Mimosa-oceanis/Mimosa-Power-Board-Hat/Images/Mimosa-Power-Hat.jpg

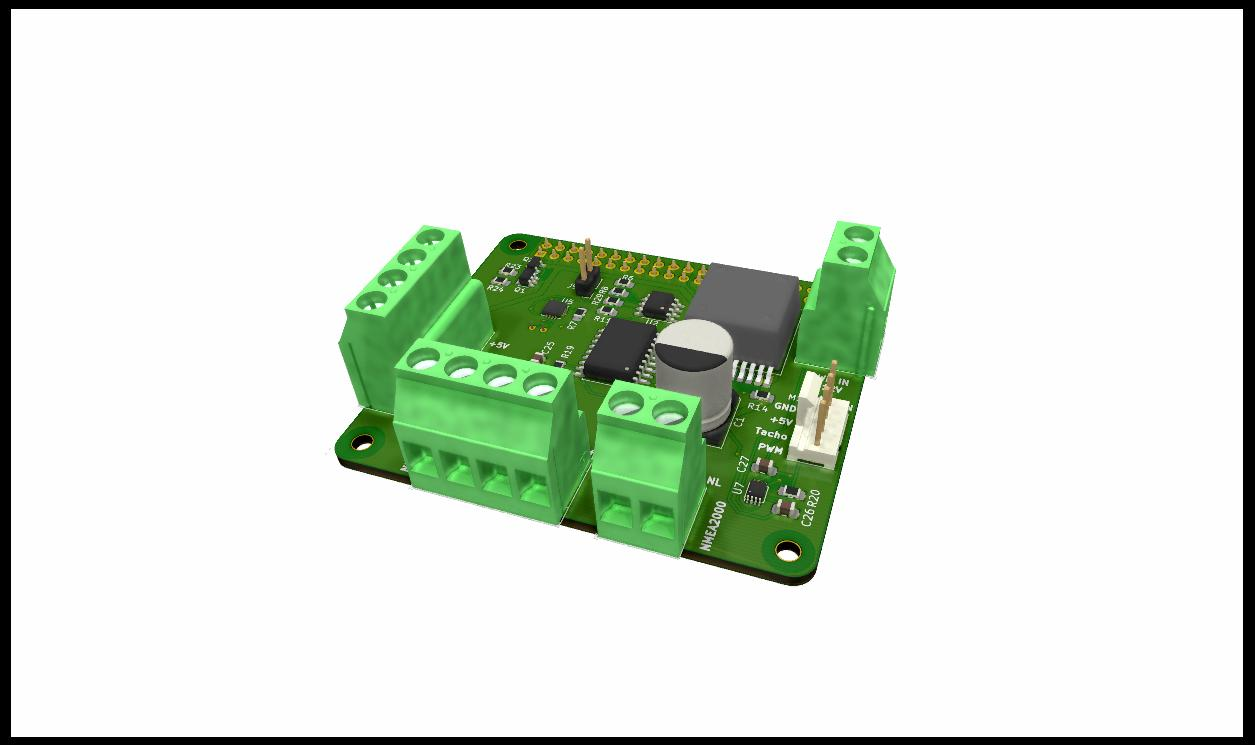
Images/Mimosa-Power-Hat.jpg
