Mimosa-oceanis/Mimosa-Power-Board-Hat/3D/Mimosa-Hat.FCStd

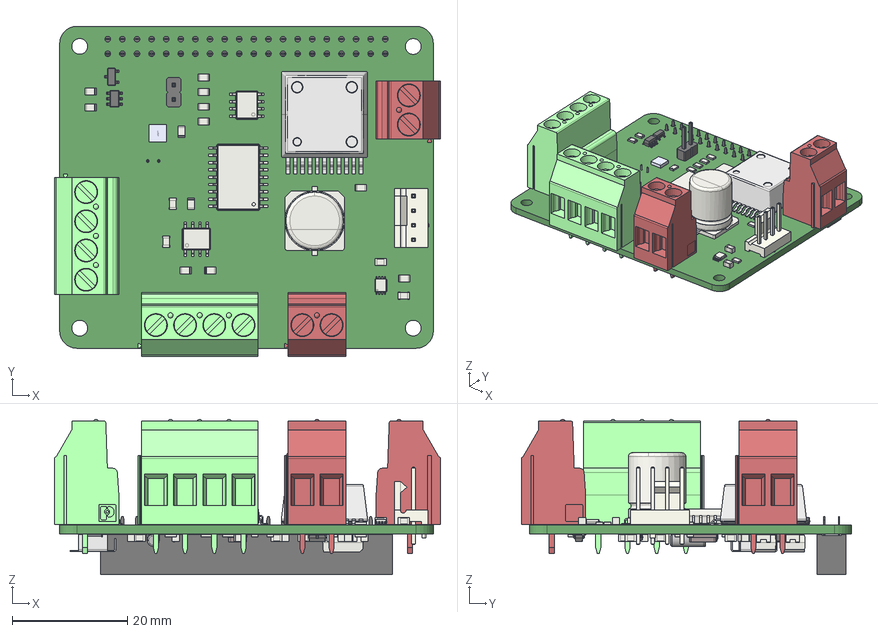
[picture p3: CAD file, 2020-08-15]
3D/Mimosa-Hat.FCStd
67.1 x 57.5 x 27.0 mm
