Mimosa-oceanis/Mimosa-Power-Board-Hat/(threads)

Thread 4 (2021-01-30):

Mixed handsolder and fine pitch components

llessa, 2021-01-30:
Replace fine pith components for ones that can be handsoldering handled.
p.ex: AB0805-T3
