Mimosa-oceanis/Mimosa-Power-Board-Hat/prod/PDF/Mimosa-Power-Hat-B_SilkS.pdf

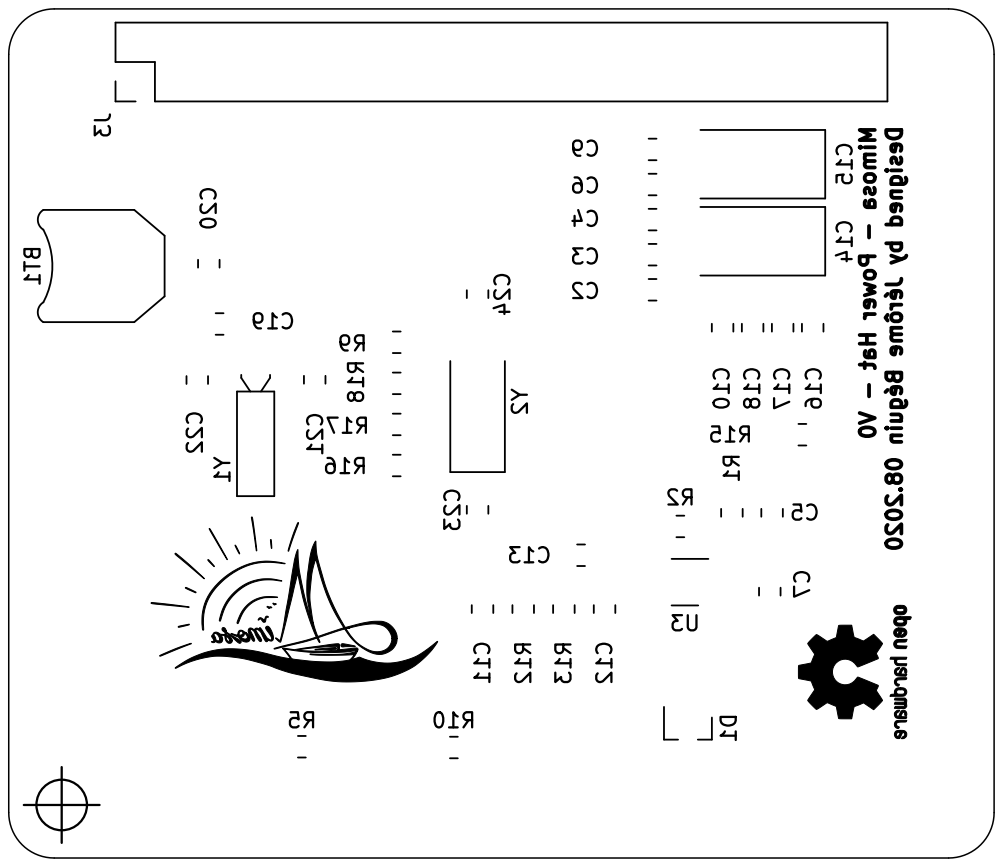
[picture p4: page 1]

Mimosa - Power Hat - V0 Designed by Jérôme Béguin 08.2020 Y1 D1 R18 R17 R16 R15 R12 R13 R10 R9 R5 R2 R1 C24 C23 C22 C21 C20 C19 C18 C17 C16 C13 C11 C12 C10 C9 C7 C6 C5 C4 C3 C2 Y2 BT1 U3 C15 C14 J3
