Mimosa-oceanis/Mimosa-Power-Board-Hat/Assembly/Mimosa-Power-Hat-B_Fab.pdf

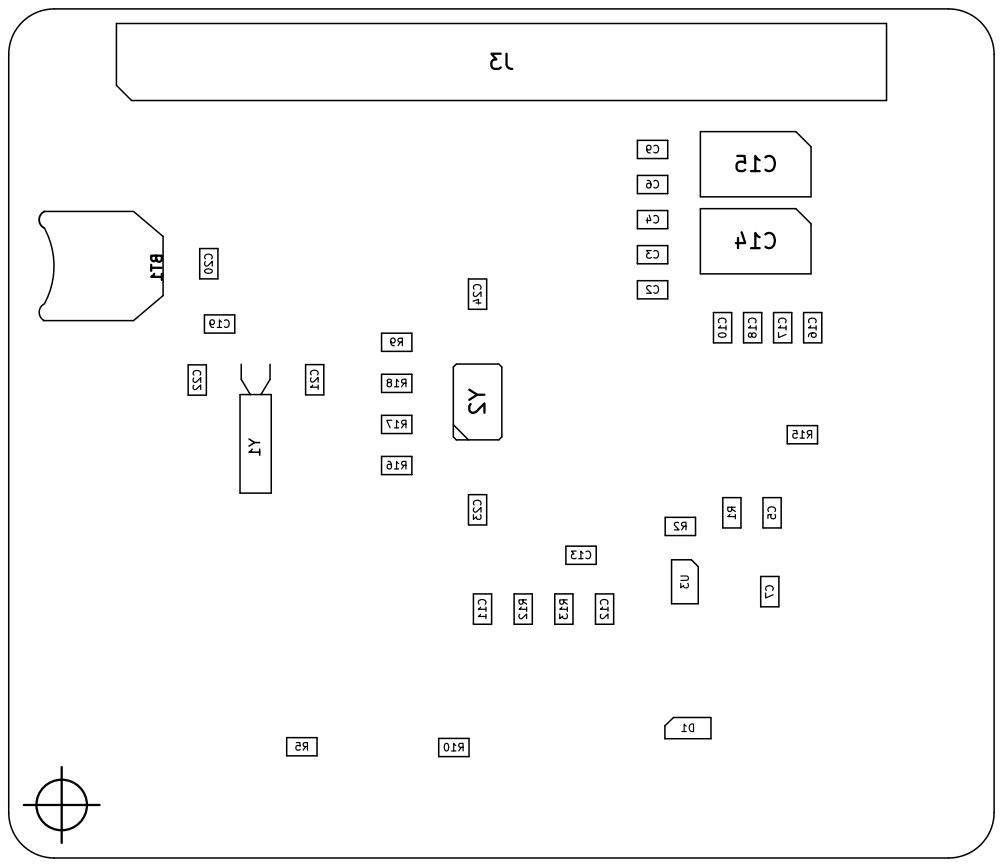
[picture p5: page 1]
