Mimosa-oceanis/Mimosa-Power-Board-Hat/Assembly/Mimosa-Power-Hat-F_Fab.pdf

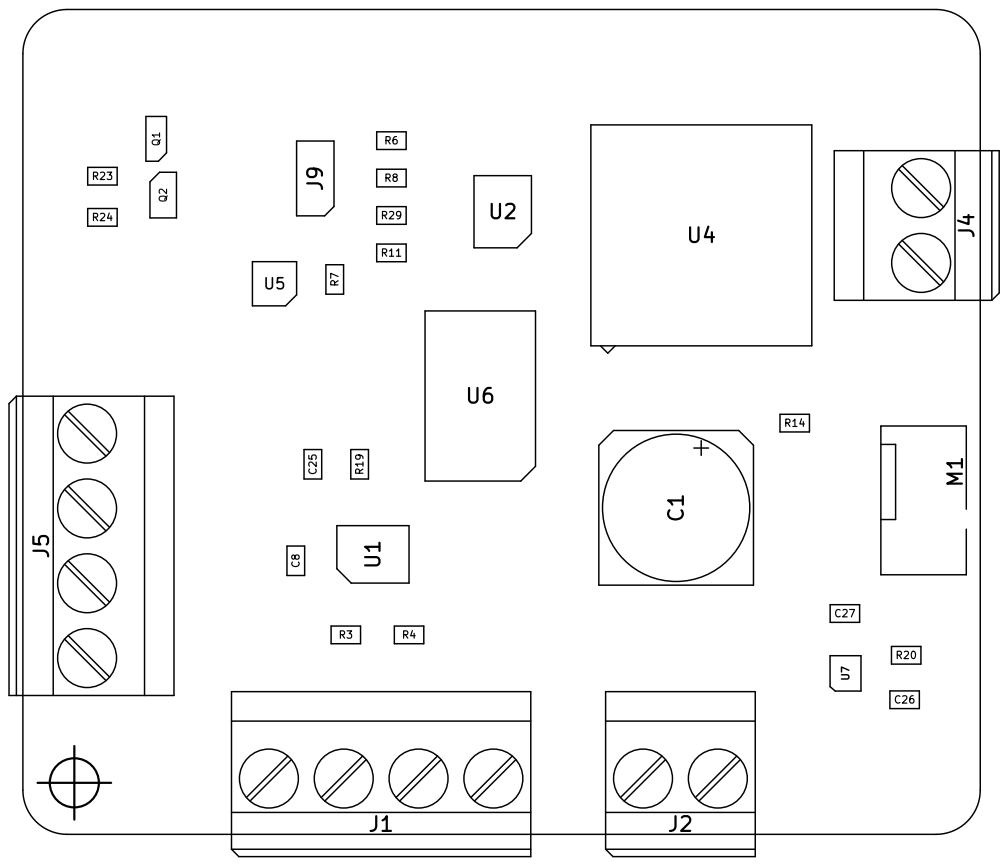
[picture p6: page 1]
