Mimosa-oceanis/Mimosa-Power-Board-Hat/prod/PDF/Mimosa-Power-Hat-B_Cu.pdf

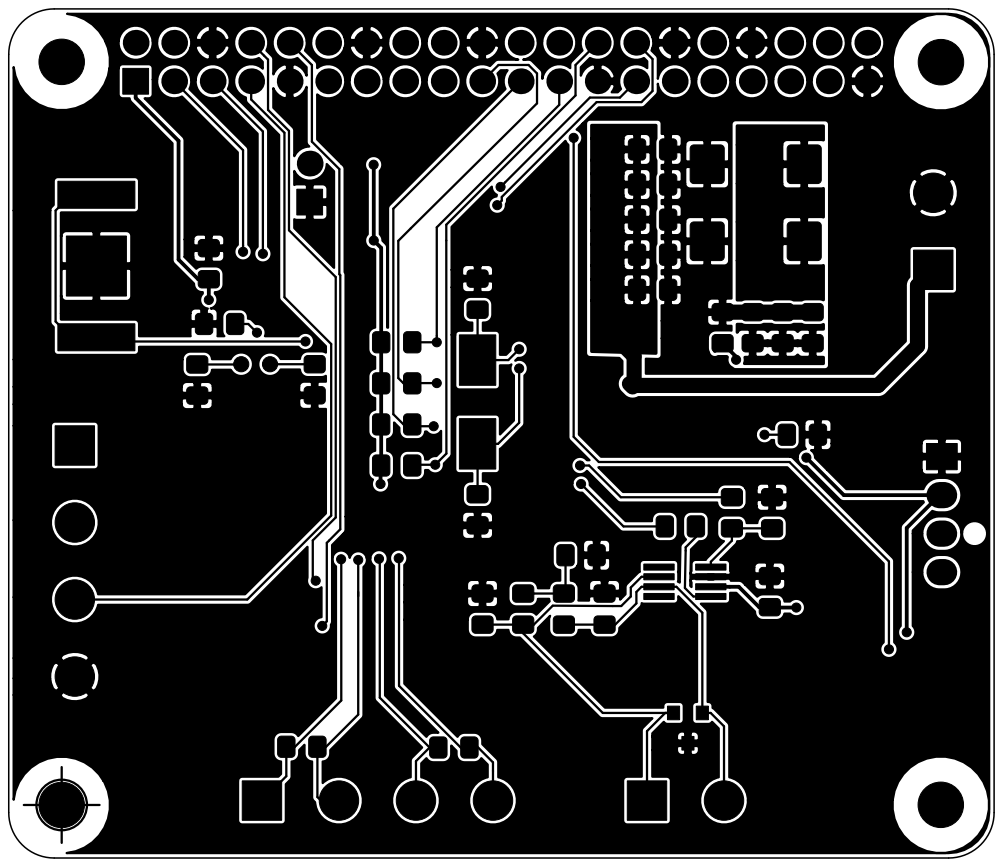
[picture p7: page 1]
