Mimosa-oceanis/Mimosa-Power-Board-Hat/prod/PDF/Mimosa-Power-Hat-B_Mask.pdf

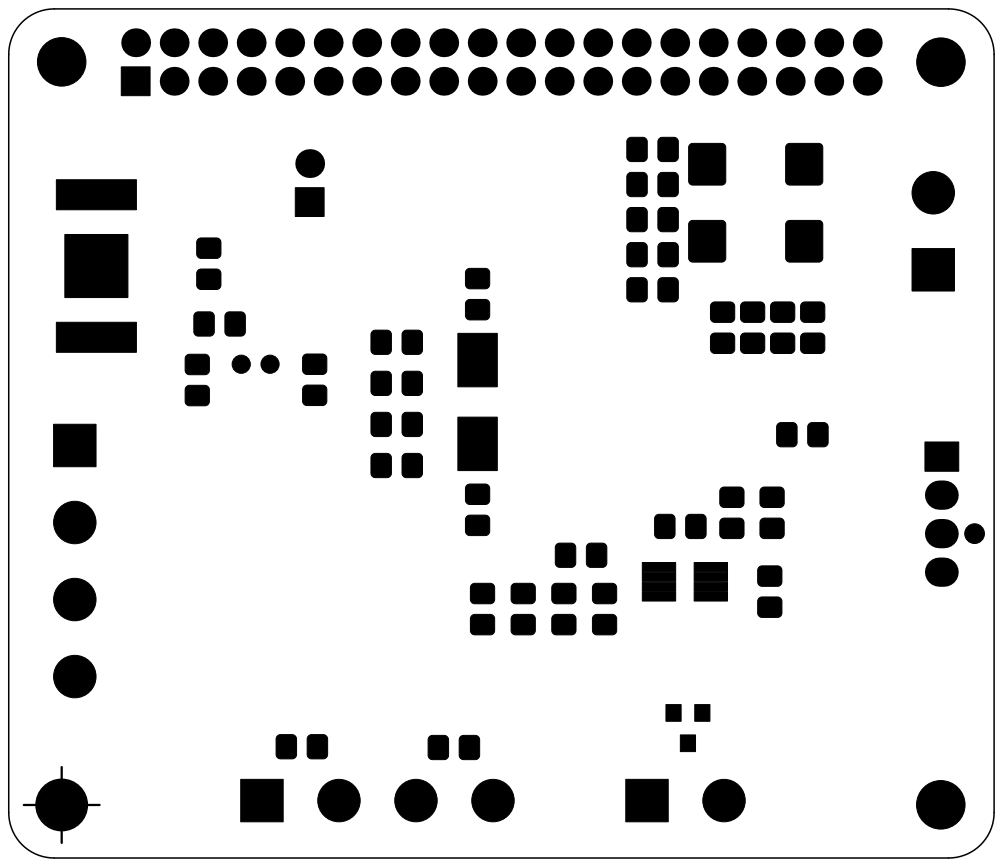
[picture p8: page 1]
