Mimosa-oceanis/Mimosa-Power-Board-Hat/prod/PDF/Mimosa-Power-Hat-B_Paste.pdf

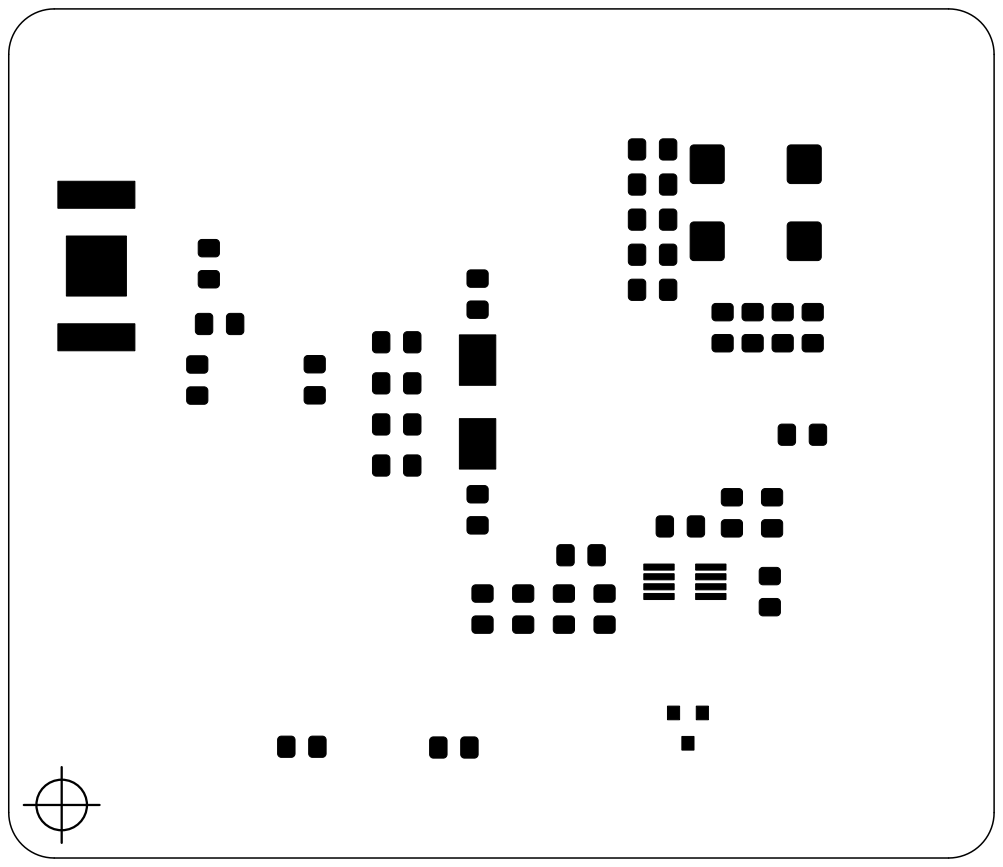
[picture p9: page 1]
