Mimosa-oceanis/Mimosa-Power-Board-Hat/prod/PDF/Mimosa-Power-Hat-Edge_Cuts.pdf

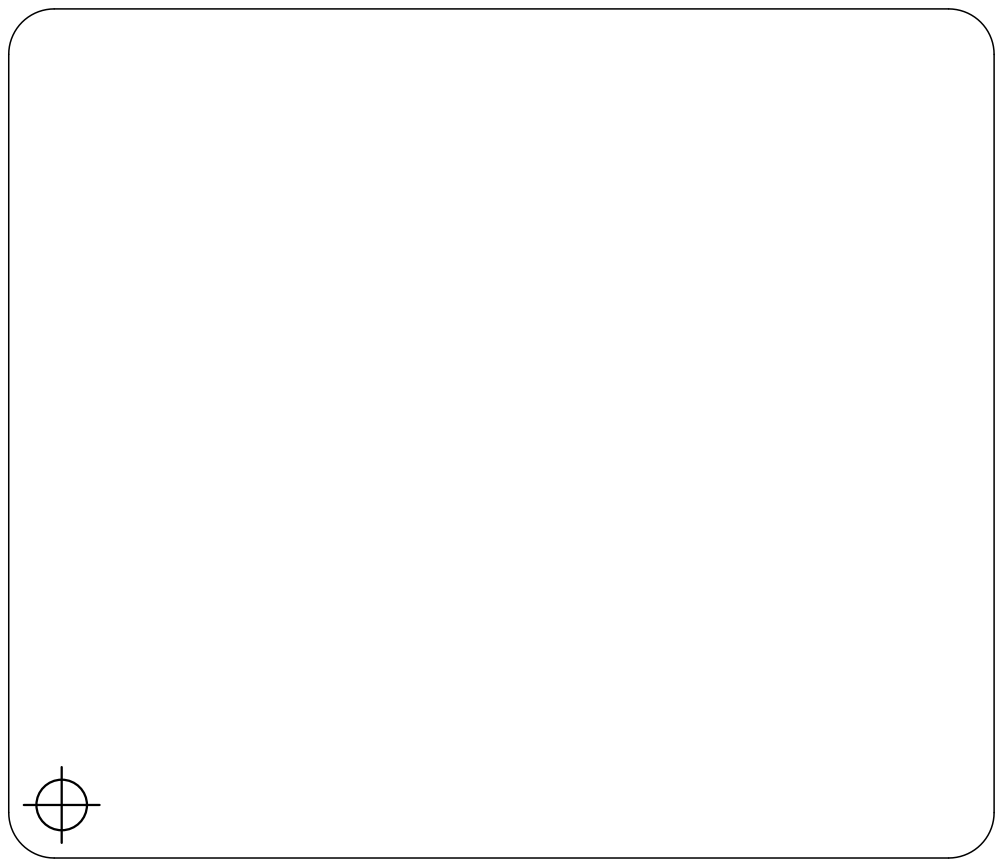
[picture p10: page 1]
