Mimosa-oceanis/Mimosa-Power-Board-Hat/prod/PDF/Mimosa-Power-Hat-F_Cu.pdf

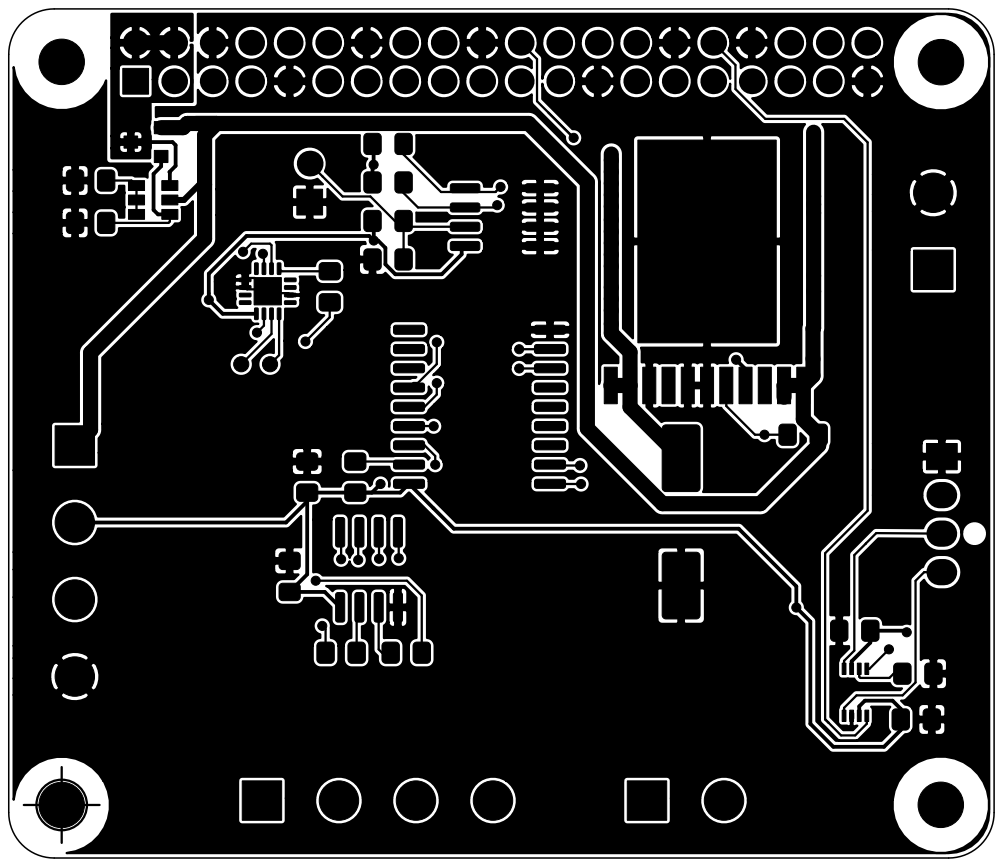
[picture p11: page 1]
