Mimosa-oceanis/Mimosa-Power-Board-Hat/prod/PDF/Mimosa-Power-Hat-F_Mask.pdf

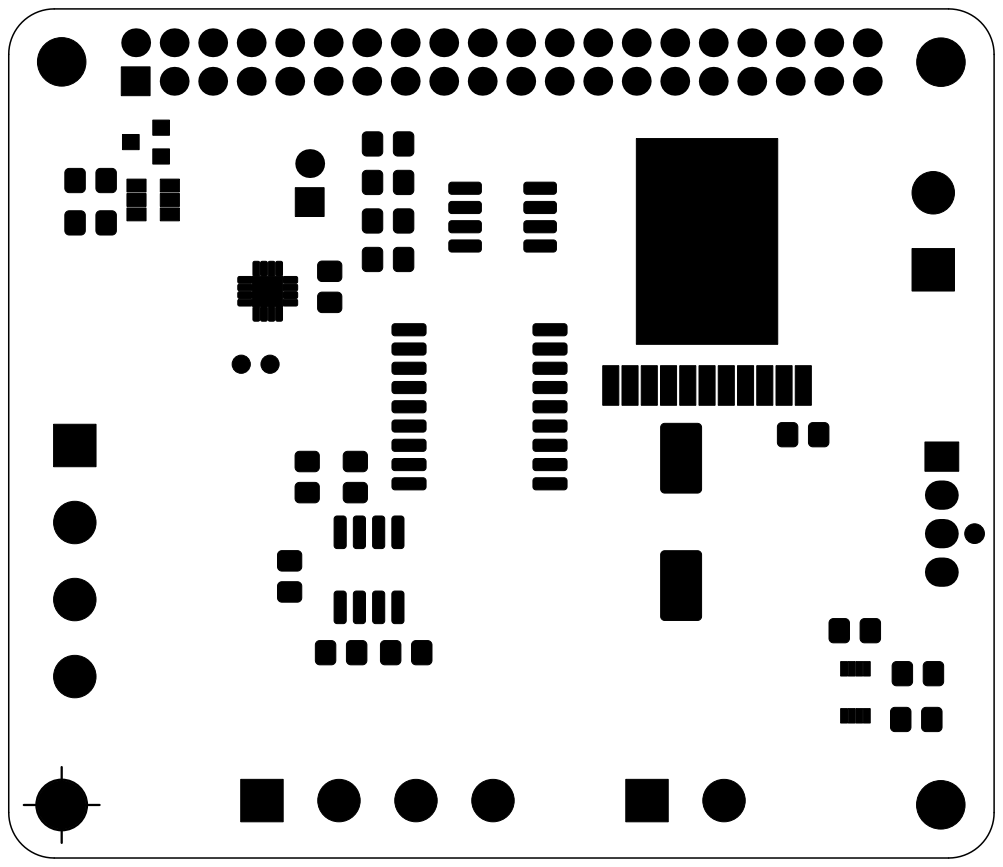
[picture p12: page 1]
