Mimosa-oceanis/Mimosa-Power-Board-Hat/prod/PDF/Mimosa-Power-Hat-F_Paste.pdf

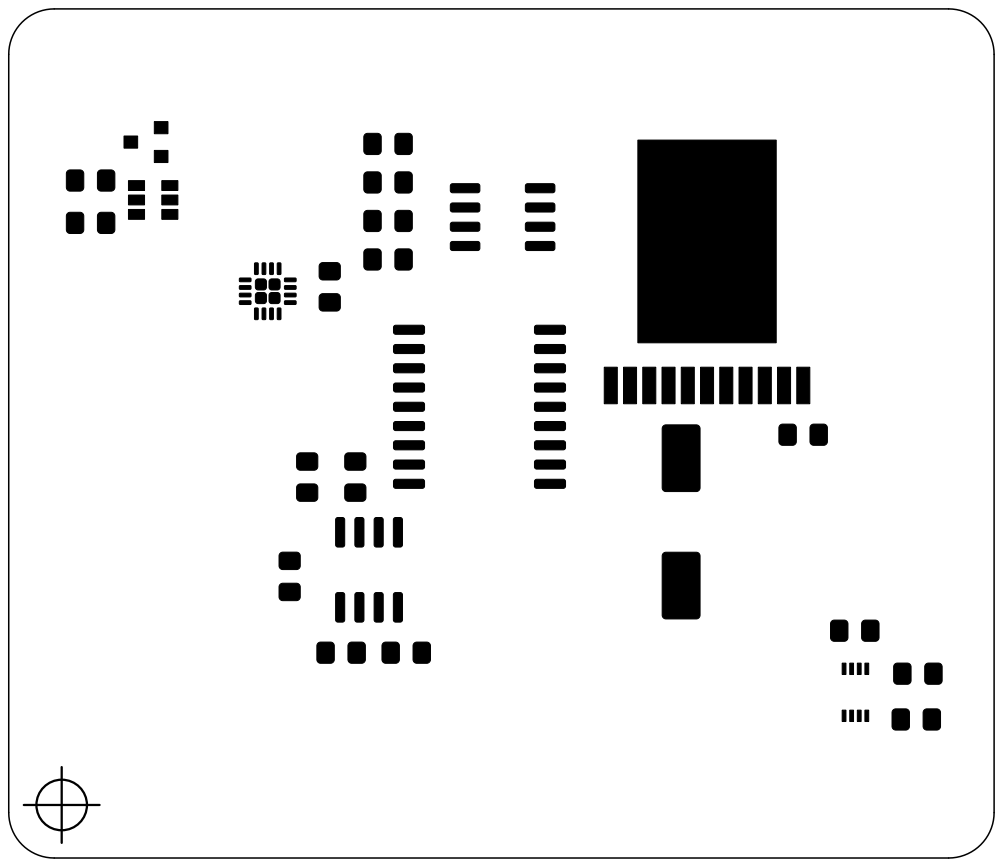
[picture p13: page 1]
