Mimosa-oceanis/Mimosa-Power-Board-Hat/prod/PDF/Mimosa-Power-Hat-F_SilkS.pdf

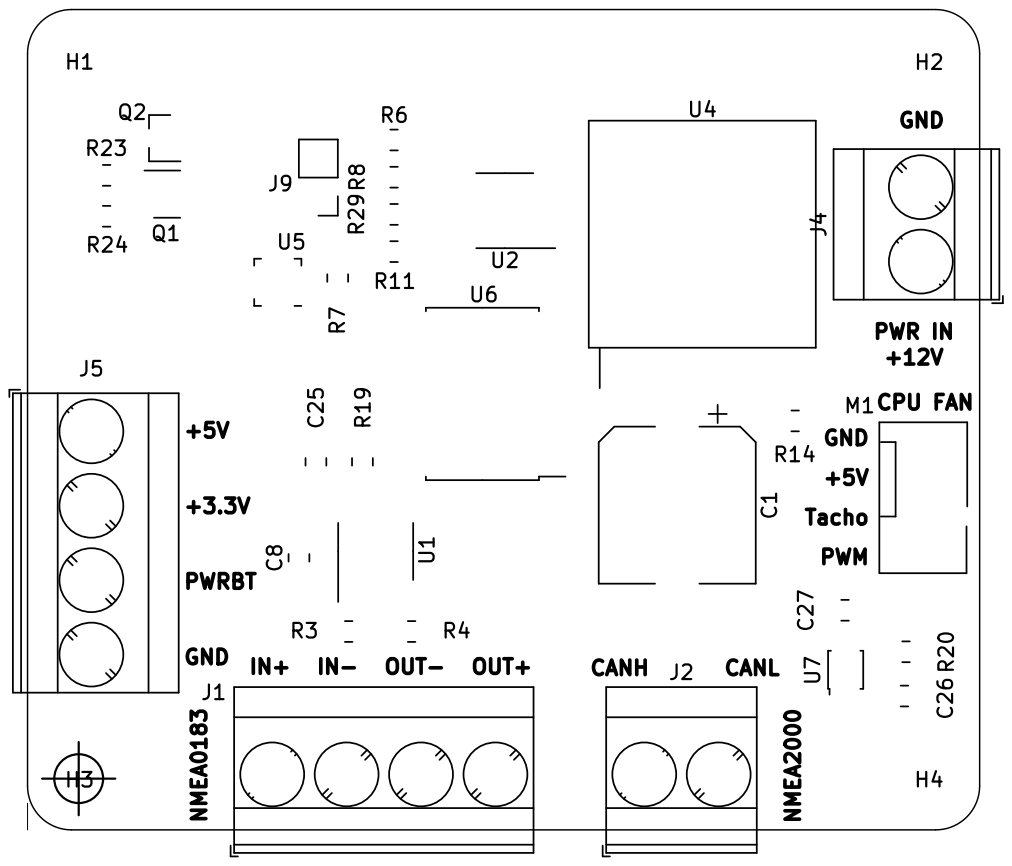
[picture p14: page 1]
