Mimosa-oceanis/Mimosa-Power-Board-Hat/Mimosa-Power-Hat.kicad_pcb

## KiCad design Mimosa-Power-Hat.kicad_pcb (2025-06-15)

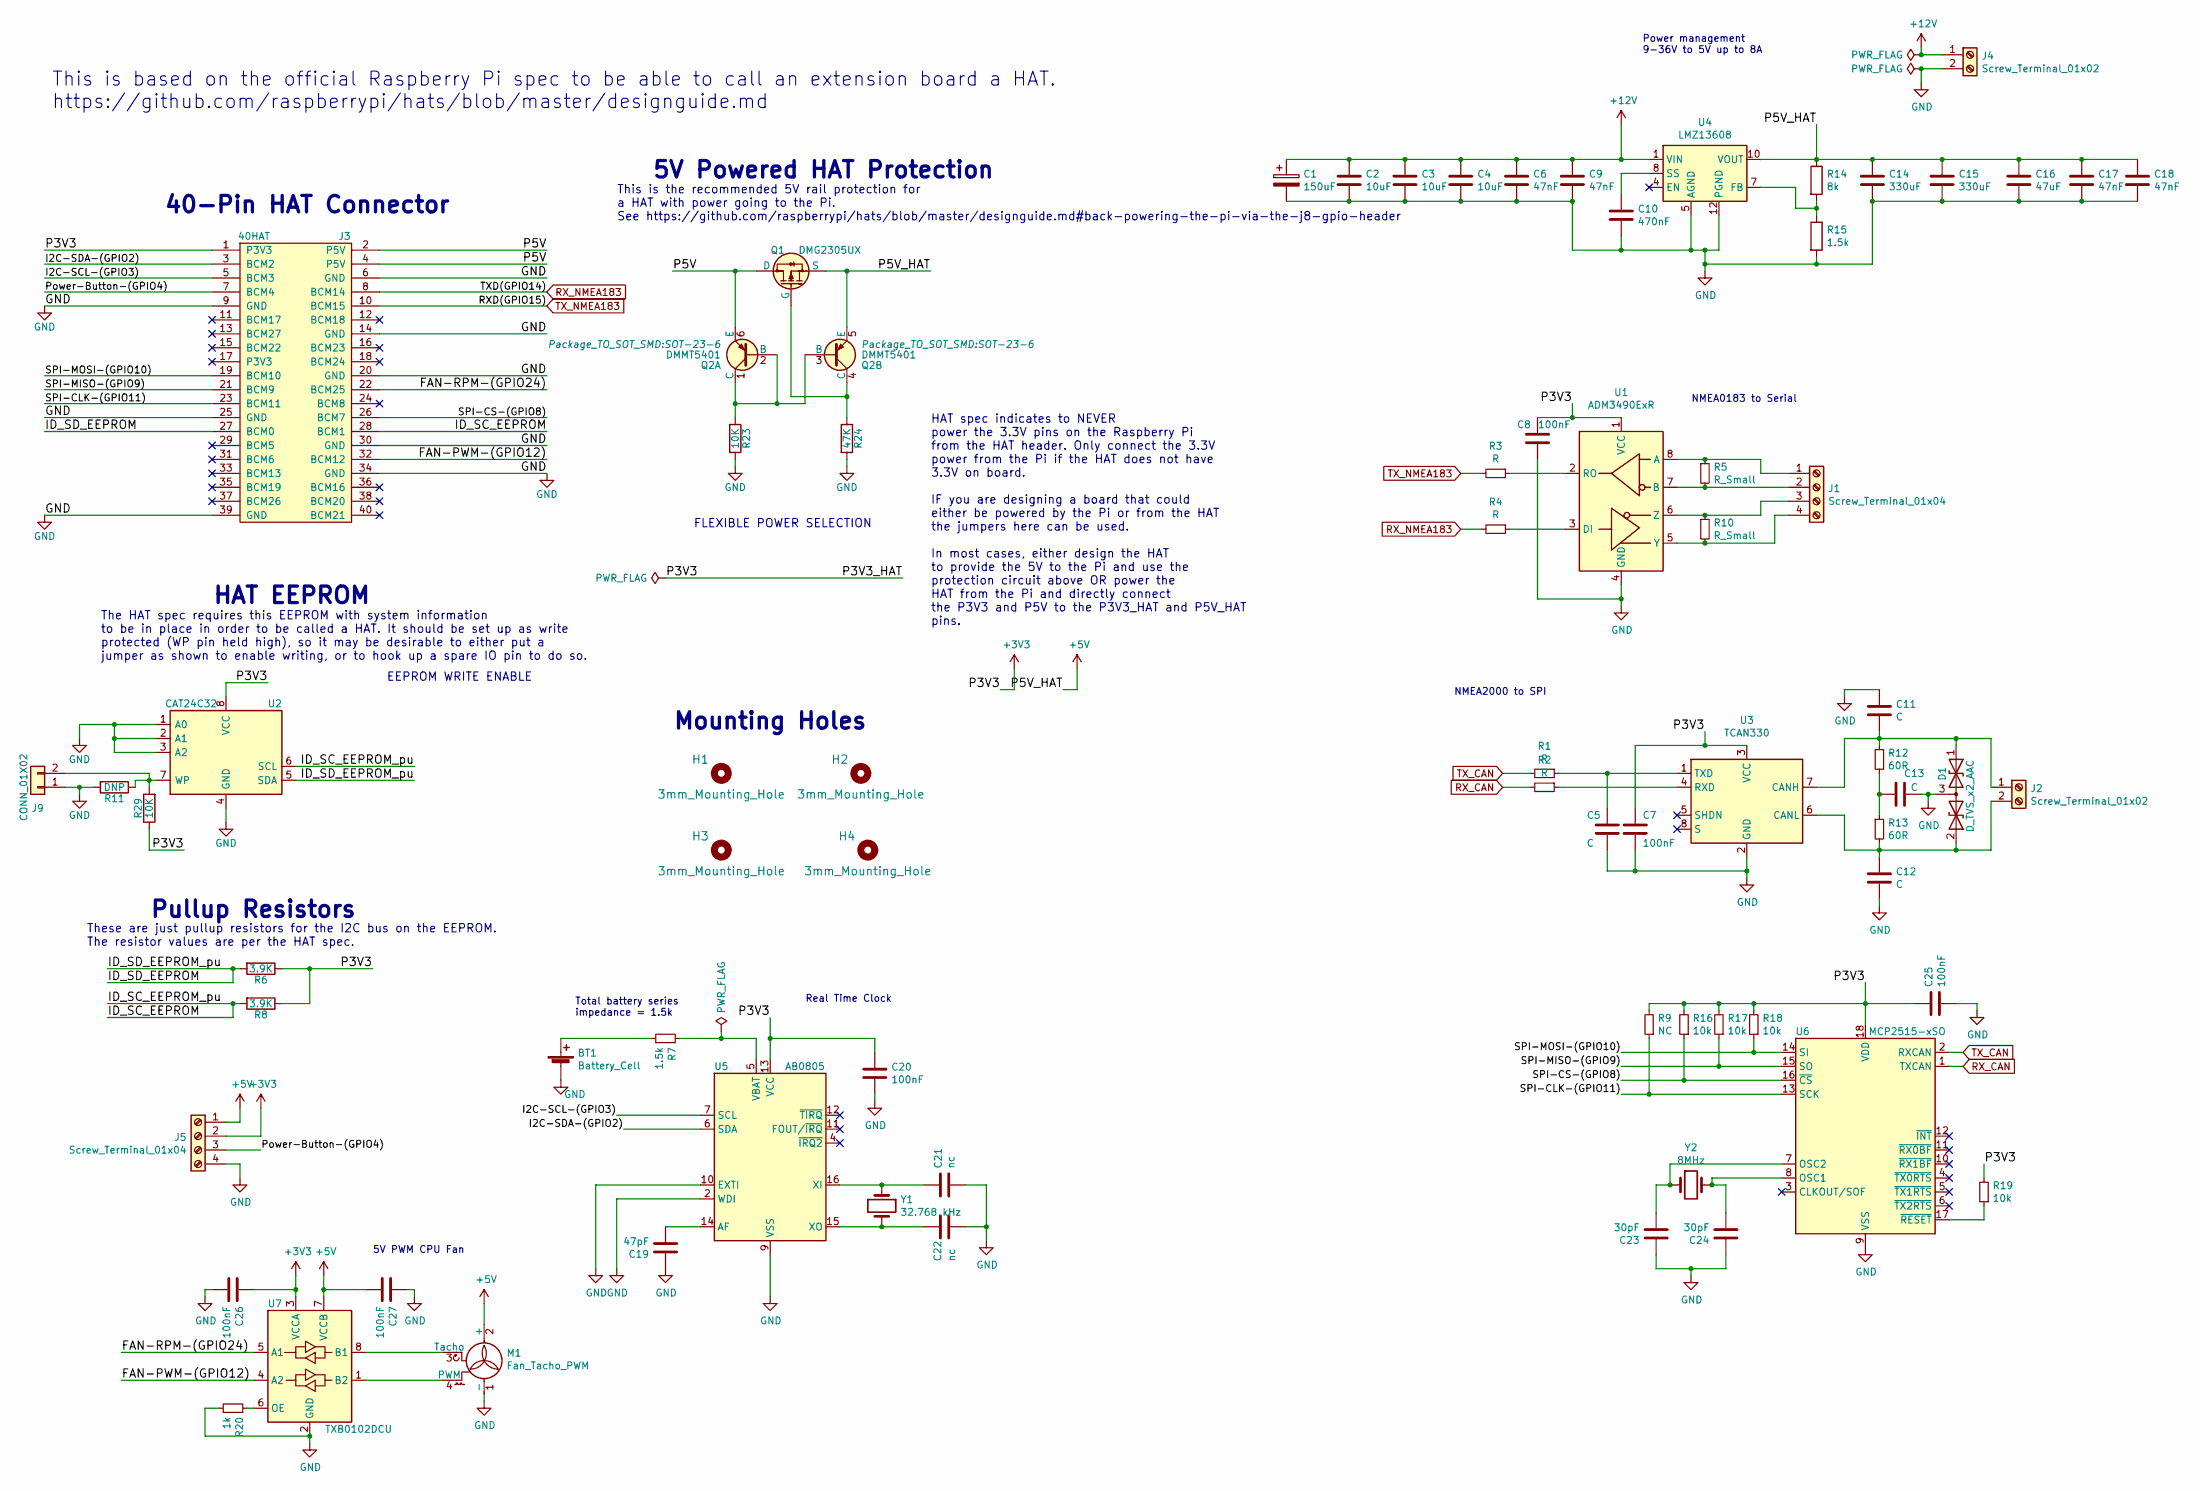
[picture p15: schematic Mimosa-Power-Hat.kicad_sch]

Parts:
BT1: Battery_Cell; BatteryHolder_Keystone_2998_1x6.8mm
C1: 150uF; CP_Elec_10x12.5
C2, C3, C4: 10uF; C_0805_2012Metric_Pad1.15x1.40mm_HandSolder
C5, C11, C12, C13: C; C_0805_2012Metric_Pad1.15x1.40mm_HandSolder
C6, C9, C17, C18: 47nF; C_0805_2012Metric_Pad1.15x1.40mm_HandSolder
C7, C8, C20, C25, C26, C27: 100nF; C_0805_2012Metric_Pad1.15x1.40mm_HandSolder
C10: 470nF; C_0805_2012Metric_Pad1.15x1.40mm_HandSolder
C14, C15: 330uF; CP_EIA-7343-31_Kemet-D_Pad2.25x2.55mm_HandSolder
C16: 47uF; C_0805_2012Metric_Pad1.15x1.40mm_HandSolder
C19: 47pF; C_0805_2012Metric_Pad1.15x1.40mm_HandSolder
C21, C22: nc; C_0805_2012Metric_Pad1.15x1.40mm_HandSolder
C23, C24: 30pF; C_0805_2012Metric_Pad1.15x1.40mm_HandSolder
D1: D_TVS_x2_AAC; SOT-23
H1, H2, H3, H4: 3mm_Mounting_Hole; NPTH_3mm_ID
J1, J5: Screw_Terminal_01x04; TerminalBlock_Phoenix_MKDS-3-4-5.08_1x04_P5.08mm_Horizontal
J2, J4: Screw_Terminal_01x02; TerminalBlock_Phoenix_MKDS-3-2-5.08_1x02_P5.08mm_Horizontal
J3: 40HAT; PinSocket_2x20_P2.54mm_Vertical
J9: CONN_01X02; PinHeader_1x02_P2.54mm_Vertical
M1: Fan_Tacho_PWM; FanPinHeader_1x04_P2.54mm_Vertical
Q1: DMG2305UX; SOT-23
Q2: DMMT5401; SOT-23-6
R1, R2, R3, R4: R; R_0805_2012Metric_Pad1.15x1.40mm_HandSolder
R5, R10: R_Small; R_0805_2012Metric_Pad1.15x1.40mm_HandSolder
R6, R8: 3.9K; R_0805_2012Metric_Pad1.15x1.40mm_HandSolder
R7, R15: 1.5k; R_0805_2012Metric_Pad1.15x1.40mm_HandSolder
R9: NC; R_0805_2012Metric_Pad1.15x1.40mm_HandSolder
R11: DNP; R_0805_2012Metric_Pad1.15x1.40mm_HandSolder
R12, R13: 60R; R_0805_2012Metric_Pad1.15x1.40mm_HandSolder
R14: 8k; R_0805_2012Metric_Pad1.15x1.40mm_HandSolder
R16, R17, R18, R19: 10k; R_0805_2012Metric_Pad1.15x1.40mm_HandSolder
R20: 1k; R_0805_2012Metric_Pad1.15x1.40mm_HandSolder
R23, R29: 10K; R_0805_2012Metric_Pad1.15x1.40mm_HandSolder
R24: 47K; R_0805_2012Metric_Pad1.15x1.40mm_HandSolder
U1: ADM3490ExR; SOIC-8_3.9x4.9mm_P1.27mm
U2: CAT24C32; SOIC-8_3.9x4.9mm_P1.27mm
U3: TCAN330; TSOT-23-8_HandSoldering
U4: LMZ13608; Texas_NDY0011A
U5: AB0805; VQFN-16-1EP_3x3mm_P0.5mm_EP1.8x1.8mm
U6: MCP2515-xSO; SOIC-18W_7.5x11.6mm_P1.27mm
U7: TXB0102DCU; VSSOP-8_2.4x2.1mm_P0.5mm
Y1: 32.768 kHz; Crystal_C26-LF_D2.1mm_L6.5mm_Horizontal
Y2: 8MHz; Crystal_SMD_Abracon_ABM3-2Pin_5.0x3.2mm_HandSoldering

Connections:
+3V3: C7.2, C8.1, C20.2, C25.2, C26.2, J3.1 (P3V3), J5.2, R6.1, R8.1, R9.2, R16.2, R17.2, R18.2, R19.2, R29.1, U1.1 (VCC), U2.8 (VCC), U3.3 (VCC), U5.13 (VCC), U6.18 (VDD), U7.3 (VCCA)
+5V: C14.1, C15.1, C16.1, C17.1, C18.1, C27.1, J5.1, M1.2 (+), Q1.2 (S), Q2.5 (E), R14.1, U4.10 (VOUT), U4.11 (VOUT), U7.7 (VCCB)
+12V: C1.1, C2.1, C3.1, C4.1, C6.1, C9.1, J4.1, U4.1 (VIN), U4.2 (VIN)
/FAN-PWM-(GPIO12): J3.32 (BCM12), U7.4 (A2)
/FAN-RPM-(GPIO24): J3.22 (BCM25), U7.5 (A1)
/I2C-SCL-(GPIO3): J3.5 (BCM3), U5.7 (SCL)
/I2C-SDA-(GPIO2): J3.3 (BCM2), U5.6 (SDA)
/ID_SC_EEPROM: J3.28 (BCM1), R8.2, U2.6 (SCL)
/ID_SD_EEPROM: J3.27 (BCM0), R6.2, U2.5 (SDA)
/P5V: J3.2 (P5V), J3.4 (P5V), Q1.3 (D), Q2.6 (E)
/Power-Button-(GPIO4): J3.7 (BCM4), J5.3
/SPI-CLK-(GPIO11): J3.23 (BCM11), R9.1, U6.13 (SCK)
/SPI-CS-(GPIO8): J3.26 (BCM7), R16.1, U6.16 (~CS)
/SPI-MISO-(GPIO9): J3.21 (BCM9), R17.1, U6.15 (SO)
/SPI-MOSI-(GPIO10): J3.19 (BCM10), R18.1, U6.14 (SI)
GND: BT1.2 (-), C1.2, C2.2, C3.2, C4.2, C5.1, C6.2, C7.1, C8.2, C9.2, C10.2, C11.2, C12.1, C13.1, C14.2, C15.2, C16.2, C17.2, C18.2, C19.2, C20.1, C21.1, C22.1, C23.2, C24.2, C25.1, C26.1, C27.2, D1.3 (common), J3.6 (GND), J3.9 (GND), J3.14 (GND), J3.20 (GND), J3.25 (GND), J3.30 (GND), J3.34 (GND), J3.39 (GND), J4.2, J5.4, J9.1, M1.1 (-), R11.2, R15.2, R20.1, R23.2, R24.2, U1.4 (GND), U2.1 (A0), U2.2 (A1), U2.3 (A2), U2.4 (GND), U3.2 (GND), U4.3 (AGND), U4.5 (AGND), U4.6 (AGND), U4.12 (PGND), U5.2 (WDI), U5.9 (VSS), U5.10 (EXTI), U5.17 (VSS), U6.9 (VSS), U7.2 (GND)
unnamed: BT1.1 (+), R7.1
unnamed: C5.2, R1.1, U3.1 (TXD)
unnamed: C10.1, U4.8 (SS)
unnamed: C11.1, D1.1 (A1), J2.1, R12.2, U3.7 (CANH)
unnamed: C12.2, D1.2 (A2), J2.2, R13.2, U3.6 (CANL)
unnamed: C13.2, R12.1, R13.1
unnamed: C19.1, U5.14 (AF)
unnamed: C21.2, U5.16 (XI), Y1.1
unnamed: C22.2, U5.15 (XO), Y1.2
unnamed: C23.1, U6.7 (OSC2), Y2.1
unnamed: C24.1, U6.8 (OSC1), Y2.2
unnamed: J1.1, R5.1, U1.8 (A)
unnamed: J1.2, R5.2, U1.7 (B)
unnamed: J1.3, R10.1, U1.6 (Z)
unnamed: J1.4, R10.2, U1.5 (Y)
unnamed: J9.2, R11.1, R29.2, U2.7 (WP)
unnamed: M1.3 (Tacho), U7.8 (B1)
unnamed: M1.4 (PWM), U7.1 (B2)
unnamed: Q1.1 (G), Q2.4 (C), R24.1
unnamed: Q2.1 (C), Q2.2 (B), Q2.3 (B), R23.1
unnamed: R2.1, U3.4 (RXD)
unnamed: R3.1, U1.2 (RO)
unnamed: R4.1, U1.3 (DI)
unnamed: R7.2, U5.5 (VBAT)
unnamed: R14.2, R15.1, U4.7 (FB)
unnamed: R19.1, U6.17 (~RESET)
unnamed: R20.2, U7.6 (OE)
RX_CAN: R2.2, U6.1 (TXCAN)
RX_NMEA183: J3.8 (BCM14), R4.2
TX_CAN: R1.2, U6.2 (RXCAN)
TX_NMEA183: J3.10 (BCM15), R3.2

Notes on the sheet:
This is based on the official Raspberry Pi spec to be able to call an extension board a HAT. https://github.com/raspberrypi/hats/blob/master/designguide.md
HAT spec indicates to NEVER power the 3.3V pins on the Raspberry Pi from the HAT header. Only connect the 3.3V power from the Pi if the HAT does not have 3.3V on board. IF you are designing a board that could either be powered by the Pi or from the HAT the jumpers here can be used. In most cases, e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
Real Time Clock
5V PWM CPU Fan
NMEA0183 to Serial
FLEXIBLE POWER SELECTION
This is the recommended 5V rail protection for a HAT with power going to the Pi. See https://github.com/raspberrypi/hats/blob/master/designguide.md#back-powering-the-pi-via-the-j8-gpio-header
Power management 9-36V to 5V up to 8A
Pullup Resistors
HAT EEPROM
EEPROM WRITE ENABLE
NMEA2000 to SPI
40-Pin HAT Connector
These are just pullup resistors for the I2C bus on the EEPROM. The resistor values are per the HAT spec.
The HAT spec requires this EEPROM with system information to be in place in order to be called a HAT. It should be set up as write protected (WP pin held high), so it may be desirable to either put a jumper as shown to enable writing, or to hook up a spare IO pin to do so.
Mounting Holes
5V Powered HAT Protection
Total battery series impedance = 1.5k

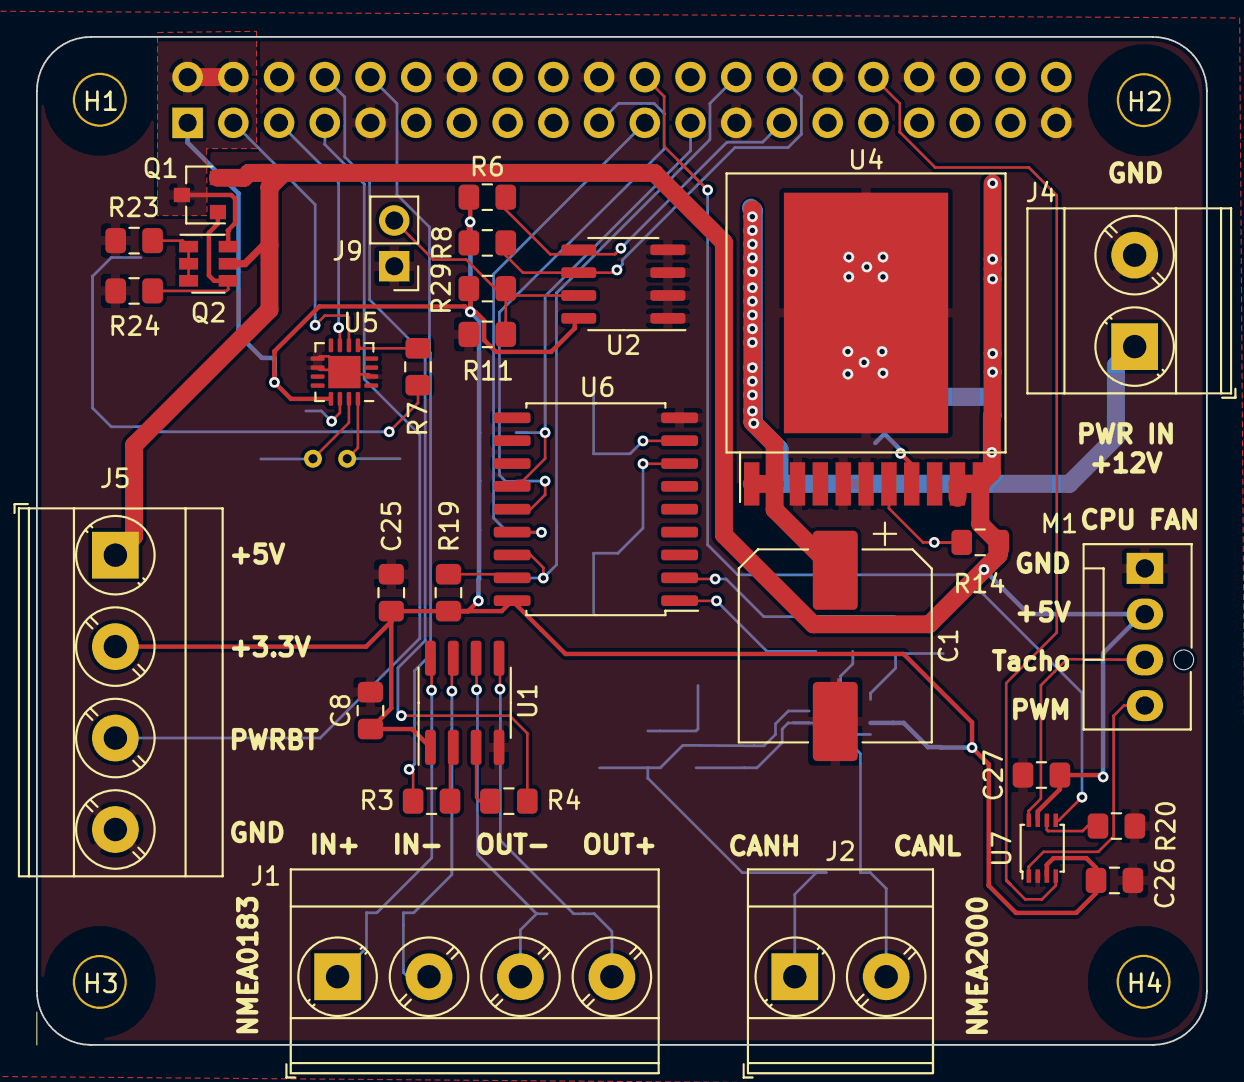
[picture p16: board Mimosa-Power-Hat.kicad_pcb from above]

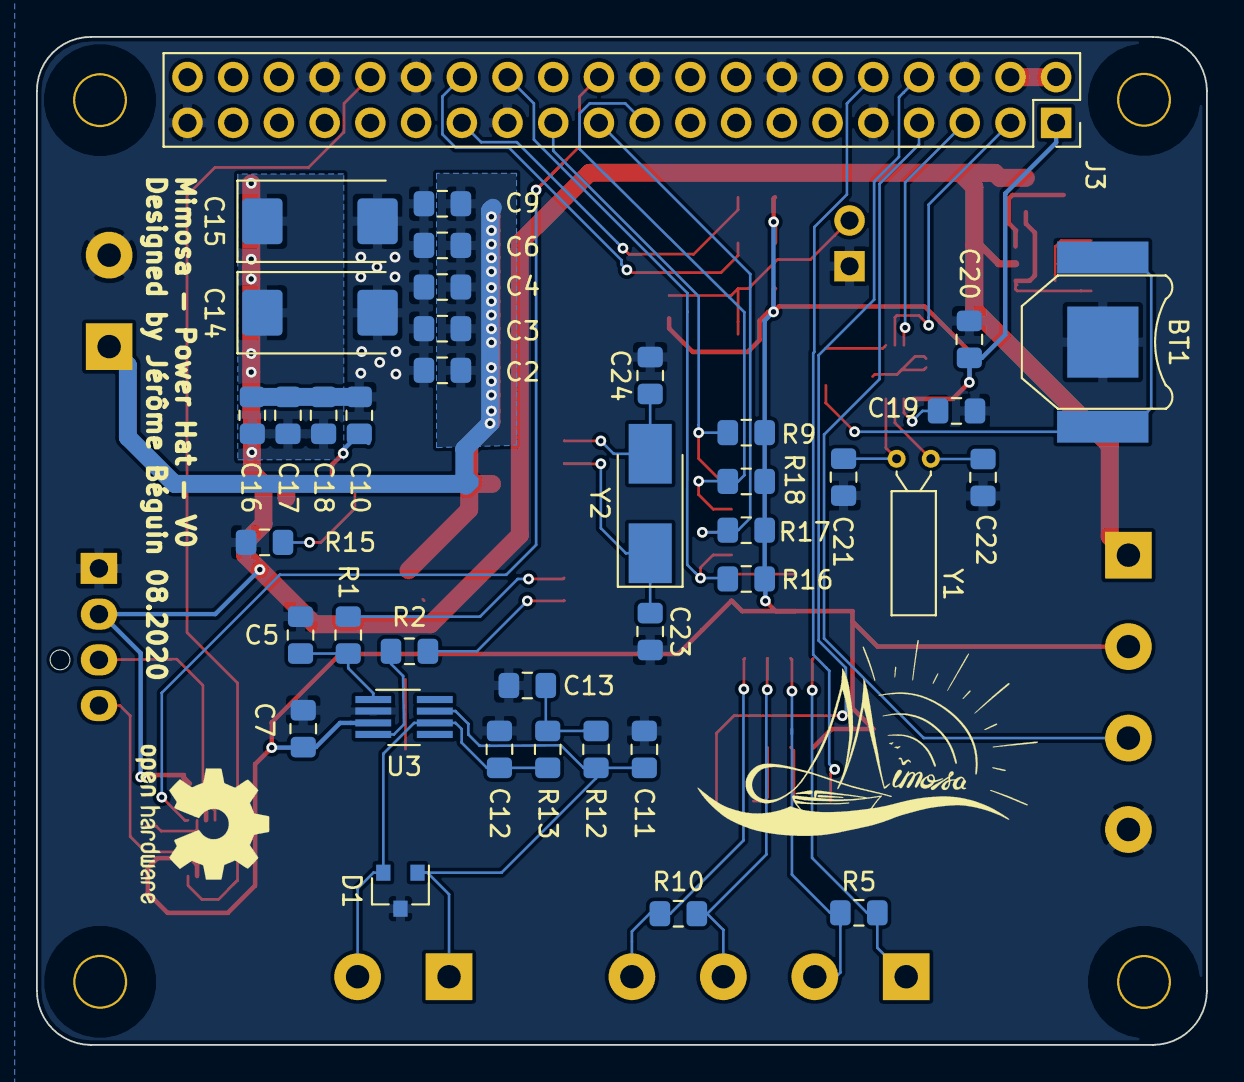
[picture p17: board Mimosa-Power-Hat.kicad_pcb from below]

Board: 2 copper layers, 65.0 x 56.0 mm, 74 parts (39 on the bottom side), 47 nets.
