Mimosa-oceanis/Mimosa-Power-Board-Hat/(commit log)

2020-05-24 Creation-of-the-file
    First save of the project.
    [Raspberry-Pi-Hat.kicad_pcb, Raspberry-Pi-Hat.sch]
2020-06-02 USB-UART
    Addition of USB-UART translator
    [Raspberry-Pi-Hat.sch, UART-USB.sch, USB-hub.sch]
2020-06-21 USB-HUB
    Implementation of USB HUB
    [Raspberry-Pi-Hat.sch, USB-hub.sch]
2020-06-23 Starting placing component
    Assigned component footprint and started placing component on the board
    [Raspberry-Pi-Hat.sch, UART-USB.sch, USB-hub.sch]
2020-06-24 Placed all component on board
    All component placed on board.
    Not many space left. Will probably reduce size of capacitors and resistors.
    [Raspberry-Pi-Hat.kicad_pcb]
2020-06-24 changed footprint size
    changed resistor and capacitor footprint size for 0603 when possible.
    [Raspberry-Pi-Hat.kicad_pcb, Raspberry-Pi-Hat.sch, UART-USB.sch, USB-hub.sch]
2020-06-25 Routted diff pair
    All USB lines is routed and most of the signal lines is routed as well.
    [Raspberry-Pi-Hat.kicad_pcb, Raspberry-Pi-Hat.sch, UART-USB.sch, USB-hub.sch]
2020-06-29 Change strategy
    Remove USB hub, connect CAN to SPI and NMEA to RSPI serial.
    Addition of RTC
    Addition of Fan PWM connector
    Plan to add a soft start button
    [Raspberry-Pi-Hat.kicad_pcb, Raspberry-Pi-Hat.sch, UART-USB.sch]
2020-08-09 Routing version SPI V0
    Replaced USB with SPI for N2K
    Power button
    RTC
    Routing done
    [Raspberry-Pi-Hat.kicad_pcb, Raspberry-Pi-Hat.sch]
2020-08-11 All 3d model included
    [Raspberry-Pi-Hat.sch]
2020-08-14 Finalisation of the Project
    Correcte last problems
    Create gerber files
    [Raspberry-Pi-Hat-B_Cu.gbr, Raspberry-Pi-Hat-B_Fab.gbr, Raspberry-Pi-Hat-B_Mask.gbr, Raspberry-Pi-Hat-B_Paste.gbr, Raspberry-Pi-Hat-B_SilkS.gbr, Raspberry-Pi-Hat-Edge_Cuts.gbr, Raspberry-Pi-Hat-F_Cu.gbr, Raspberry-Pi-Hat-F_Fab.gbr]
2020-08-14 adding BOM to prod folder
    [Raspberry-Pi-Hat.sch, Raspberry-Pi-Hat_bom_A.xlsx]
2020-08-15 Rename project and files and re-export prod files
    [Mimosa-Hat.FCStd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]
2020-08-16 Add 3d Model
    [Mimosa-Power-Hat.kicad_pcb]
2020-08-16 reorganizing folder architerture
    [Mimosa-Hat.FCStd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]
2020-11-03 Assembly documents
    adding Assembly files
    [Mimosa-Power-Hat.kicad_pcb, Mimosa-Power-Hat.sch, Mimosa-Power-Hat_Liste-Matériel.csv, Raspberry-pi-4.FCStd]
2020-11-22 Adding testing protocol
    [Mimosa-Power-Hat.kicad_pcb]
2020-12-10 Correction of silk postion of Q1 and Q2
    [Mimosa-Power-Hat.kicad_pcb, Mimosa-Power-Hat.sch]
2022-01-08 update to Kicad 6
    [Mimosa-Power-Hat.kicad_pcb, Mimosa-Power-Hat.kicad_sch]
2025-06-15 update project to last kicad version and cleaned the repo a bit
